timat06/Projet_Peip2_Macri_Dyla/Rapports_Macri/Rapport_individuel_séance7.docx

Rapport individuel de séance n°7

Objectif : finir la conception du labyrinthe sur onshape et donner mon code à Mathilde

Choses que j’ai faites :

-Rassemblage de mes codes (voir code_enigme_version3) pour les donner à Mathilde (cette dernière s’occupe de les regrouper).

-Récupération de matériels manquants (plusieurs servo-moteurs, support de pilles et interrupteur on/off pour allumer éteindre la boîte).

-La modélisation 3D est reparti de 0 pour travailler de façon différente (la 1ère version n’est plus disponible car j’ai repris la modélisation sur le même document). Décomposition du labyrinthe en plusieurs pièces (partie inférieur et le labyrinthe pour le moment), refonte du labyrinthe car ce dernier était trop remplie (pas assez de place pour la taille de ce dernier ~10cm).

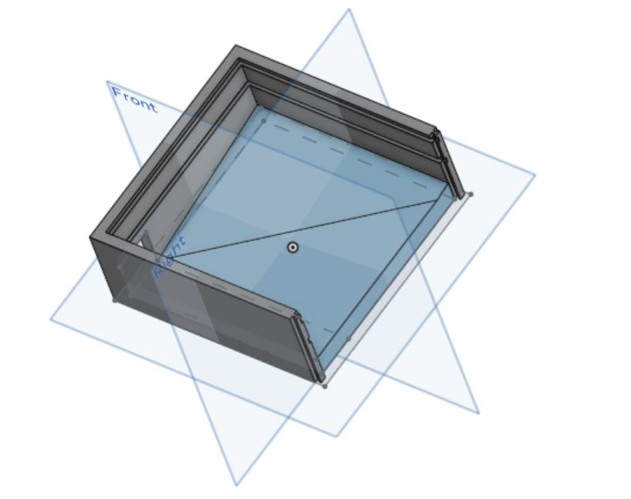
[picture p5: figure]
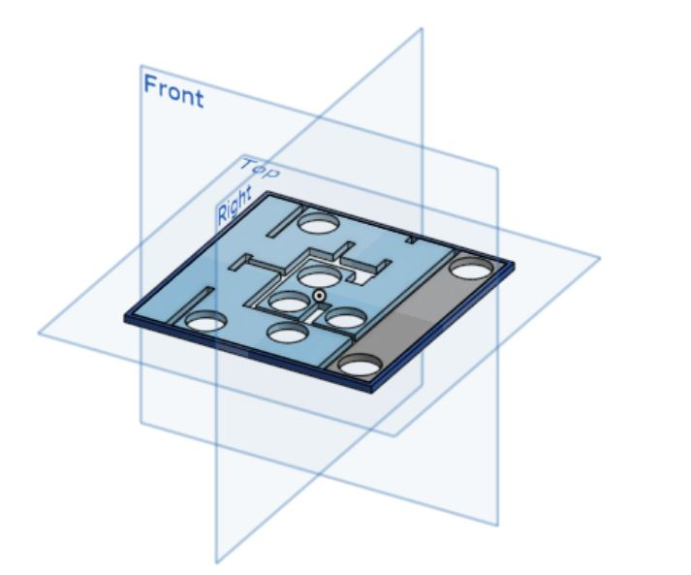
[picture p6: figure]

Voir https://cad.onshape.com/documents/1a0e342525f5fde471dca02b/w/c0911cd7855c91cec4350799/e/6f94d7121a22df6e678a639c pour avancement)

Pour la prochaine fois :

Envoie du plan fini au professeur pour pouvoir l’imprimer ce week-end, construction boîte sur onshape et voir retour avec Mathilde pour cette l’agencement.
