timat06/Projet_Peip2_Macri_Dyla/Cahier des charges/Cahier_des_charges_projet_Dyla_Macri.odt

Projet arduino boîte escape game

Cahier des charges :

Une boîte de jeu dont le but est de résoudre des énigmes, il y a 6 énigmes tout autour de la boîte fonctionnant avec arduino, elles peuvent être visuelles, des épreuves d’adresses, ou auditives, on possède un temps limité pour résoudre la boîte, le minuteur sera visible et on aura une voix pour mettre en place un scénario et nous aider durant notre avancement.
