timat06/Projet_Peip2_Macri_Dyla/Projet elec DYLA MACRI.pdf

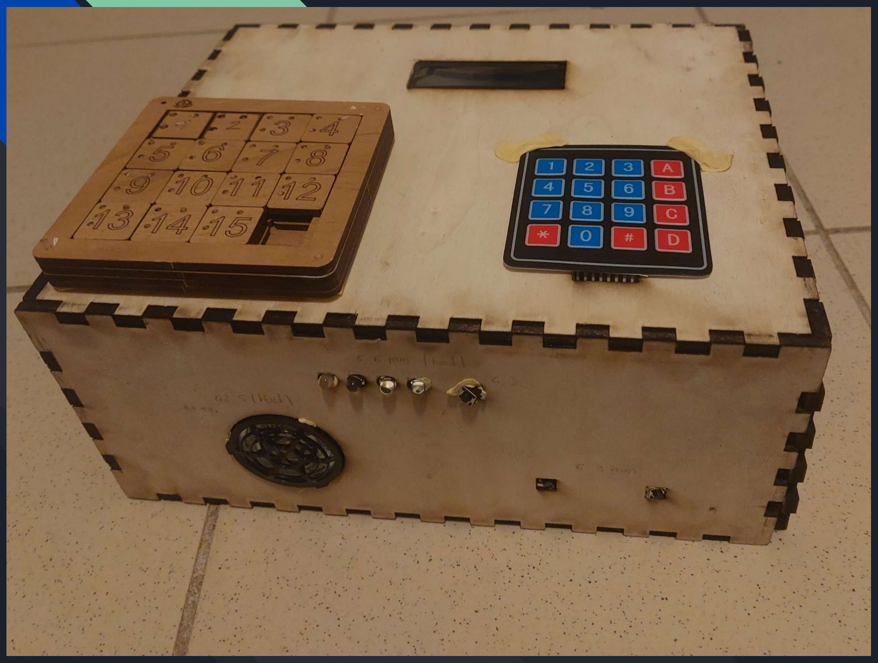
[picture p22: figure]

# Escape Game

# Mini cahier des charges

-Une boîte assez petite pour être manipuler facilement par un adulte

-6 énigmes à résoudre dans un temps imparti

-Présence d’effets sonore

-Présence de tiroirs

-Écran indiquant le temps restant

# Schéma électrique montage général

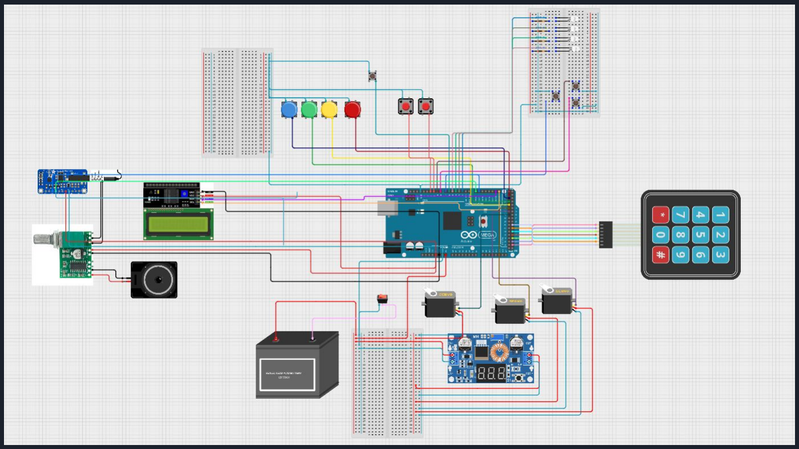
[picture p23: figure]

# 1ère, 2ème et 3ème énigme

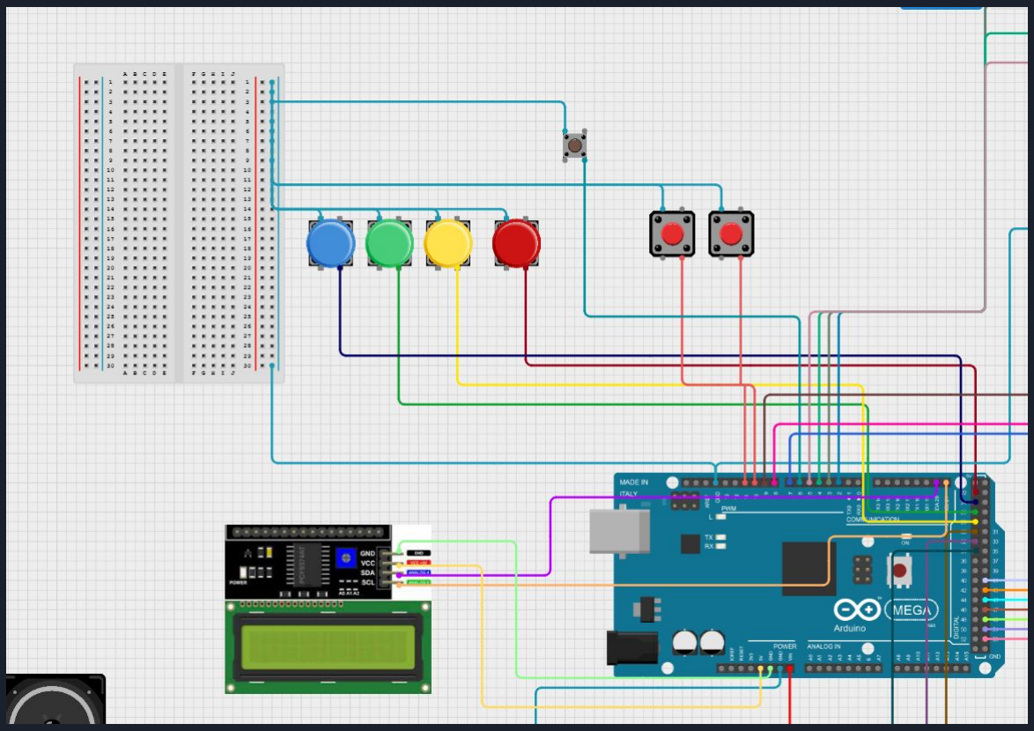
[picture p24: figure]

# 4ème, 5ème et 6ème énigme

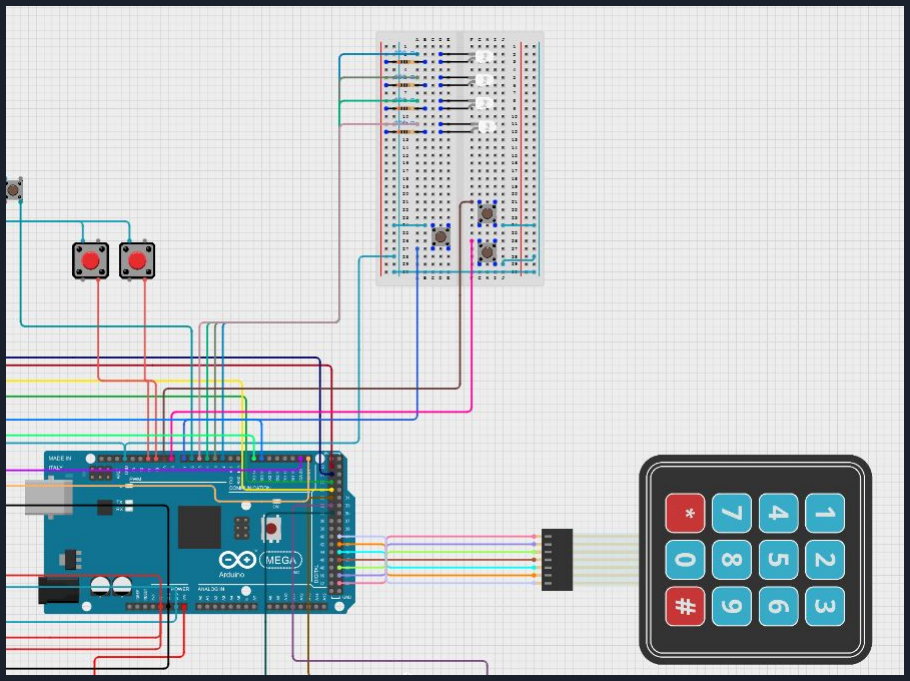
[picture p25: figure]

# Servomoteurs + alimentation

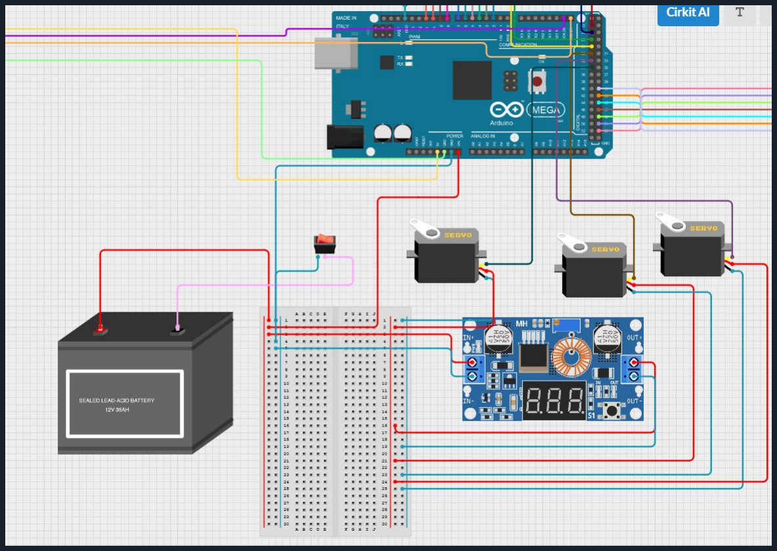
[picture p26: figure]

# Écran + son

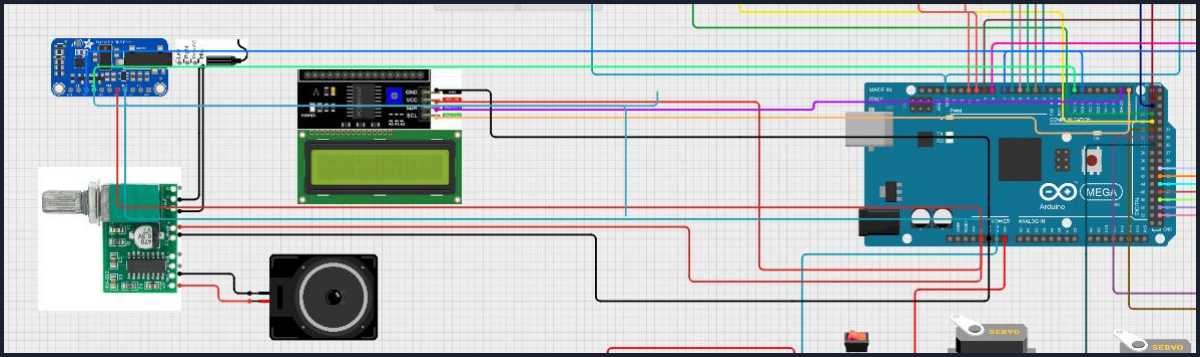
[picture p27: figure]
