timat06/Projet_Peip2_Macri_Dyla/Rapports DYLA/Séance8-DYLA.docx

# Rapport de séance n°8

J’avais entièrement fini le rassemblement du code pendant la semaine, il ne manque donc plus que la boîte pour que le projet soit terminé, comme c’est Mathys qui s’en occupe, j’ai surtout fait des finitions pendant la séance, comme prendre des câbles plus longs pour pouvoir répartir les composants dans la boîte plus facilement.

J’ai aussi aidé Mathys avec sa dernière énigme, le labyrinthe. J’avais remarqué que les touch sensors qu’il avait utilisé pour vérifier que la bille est arrivée à la fin, étaient un peu recouvert par le sol du labyrinthe et qu’ils seraient probablement toujours considérés comme appuyés. En effet j’ai fait les tests de fonctionnement de son énigme et surtout des boutons, et ils étaient tout le temps en état low.

Pour faire les tests j’ai donc dû faire la programmation de son énigme, c’est-à-dire définir 2 boutons, récupérer leurs valeurs et si les deux ont été appuyés c’est gagné.

J’ai donc proposé d’utiliser des capteurs de pression comme c’est plat et à peu près de même taille, en espérant que la bille serait assez lourde pour être détectée. J’ai cherché les branchements et un code basique de fonctionnement pour tester, mais la bille était trop légère pour être détectée, donc Mathys agrandira les trous pour régler le problème.

Comme on reste sur les boutons, j’ai ajouté le code de tests au rassemblement des codes en ajoutant les conditions de début et de fin de l’énigme.

Enfin j’ai refait un test de toutes les énigmes pour être sûre.

Pendant la semaine, j’ai ajouté un bruit de prise en compte lorsqu’on appuie sur un bouton de réponse et un bruit d’erreur lorsqu’on se trompe, ainsi qu’un bruit de démarrage de la boîte.
