timat06/Projet_Peip2_Macri_Dyla/Rapports_Macri/Rapport_individuel_séance3.odt

Rapport individuel de séance n°3

Objectif : continuer de concevoir le code et les branchements de l’énigme n°2

Chose faites :

-vérification du fonctionnement des leds.

-apprendre le fonctionnement des matrices.

-Petite modification du code pour l’énigme 2 (ne fonctionne pas actuellement), il sera plus facile de tester avec un support physique. Code trouvable dans le répertoire code_énigme_2_Mathys.

-voir pour la confection du jeu de taquin.

-découverte du logiciel inkscape.

-tentative de création du jeu de taquin (ancienne tentative sur inkshape, nom du fichier dessin).

-prendre un jeu de taquin sur internet dans lequel on introduira les capteurs.

-lien du jeu de taquin :

https://www.amazon.fr/TaquiWood-Puzle-Tree-puzle-Beech/dp/B0CMG4M33V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

-test du temps pour résoudre un taquin 3X3 et 4X4 pour voir la difficulté (le but est de résoudre la boîte en moins de 20minutes).

-Temps de résolution d’un jeu de taquin 3X3 :

Mathys (32 secondes)

Tahitoa (1minutes 40secondes)

Quentin (1 minutes 22 secondes)

Temps de résolution d’un jeu de taquin 4X4 :

Quentin(1 minutes 50 secondes)

Tahitoa(4 minutes 38 secondes)

Mathys(3 minutes 49 secondes)

-J’hésite toujours mais l’utilisation d’un jeu de taquin 4X4 n’est pas à retirer.

A faire la prochaine fois :

En attendant de recevoir le jeu de taquin il faut que je me penche sur la 3ème énigme et sur l’agencement de la boîte.

Je devrais aussi faire plus de test pour le temps moyen de résolution du jeu de taquin en 3X3 et 4X4.
