timat06/Projet_Peip2_Macri_Dyla/Enigmes/code_enigme2_Mathys/Test/Test.ino

int num1=0; /valeur atribuer à la photodiote ligne 1 et colonne 1.
int num2=0; /valeur atribuer à la photodiote ligne 1 et colonne 2.
int num3=0; /valeur atribuer à la photodiote ligne 2 et colonne 1.
int num4=0; /valeur atribuer à la photodiote ligne 2 et colonne 2.
void setup() {
Serial.begin(9600);
}

void loop() {
num1=analogRead(A0); /lecture de la photodiote ligne 1 et colonne 1.
num2=analogRead(A1); /lecture de la photodiote ligne 1 et colonne 2.
num3=analogRead(A2); /lecture de la photodiote ligne 2 et colonne 1.
num4=analogRead(A3); /lecture de la photodiote ligne 2 et colonne 2.
//Serial.println(num1);
//Serial.println(num2);
//Serial.println(num3);
Serial.println(num4);
}
